kayatmd661-bit/firmware/(notices)

Notices in the files:
JARVIS-V4/README.md:
License: MIT
